mvieira4/ECE-388-Pattern-Generator-Git/README.md

# ECE-388-Pattern-Generator-Git
Demo https://youtu.be/JeO_5P8q-XI
