mvieira4/ECE-388-Pattern-Generator-Git/Report/Vieira-ECE-388-Title.tex

\begin{titlepage}
    \begin{center}
        \vspace*{4cm}

        \Huge
        \textbf{ECE-388}
        
        \Large
        \vspace{0.5cm}
        Final Project: Pattern Generator 
        
        \vspace{8.5cm}
        \textbf{Marcel Vieira}
    
        December 8, 2020
        
        \small
        \vspace{0.5cm}
        I Marcel Vieira certify that this is lab report consists only of work that is my own.
        
    \end{center}
\end{titlepage}
