mvieira4/ECE-388-Pattern-Generator-Git/Report/circuit.pdf

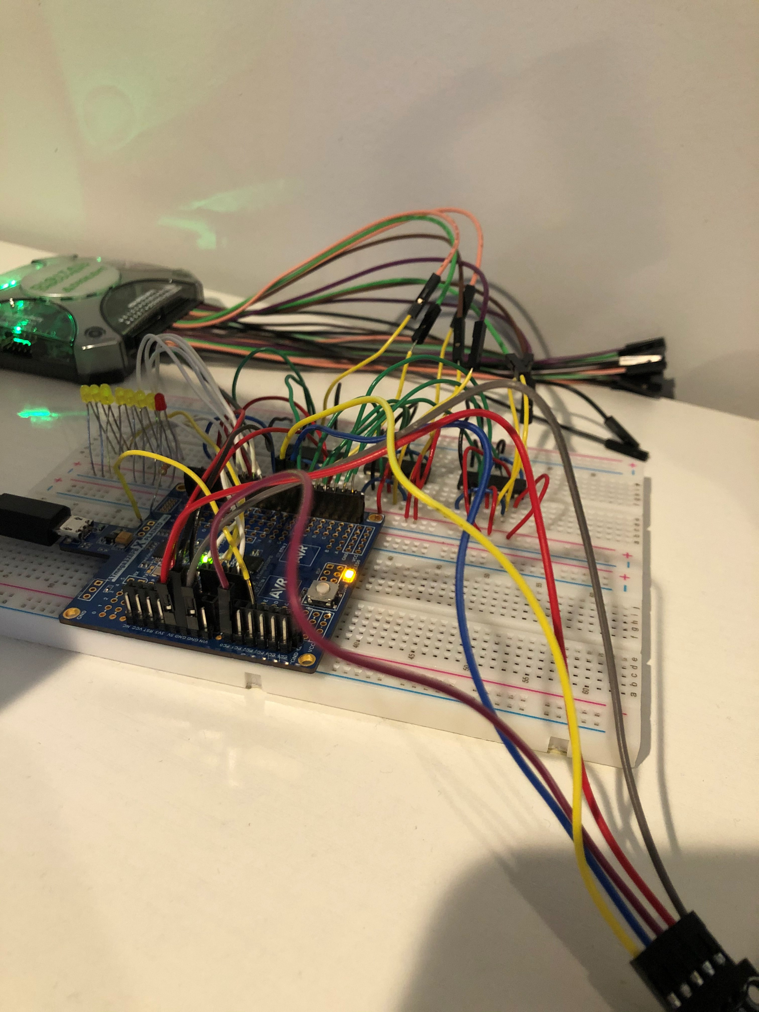
[picture p22: page 1]
