mvieira4/ECE-388-Pattern-Generator-Git/Report/ECE-388 pwr1.pdf

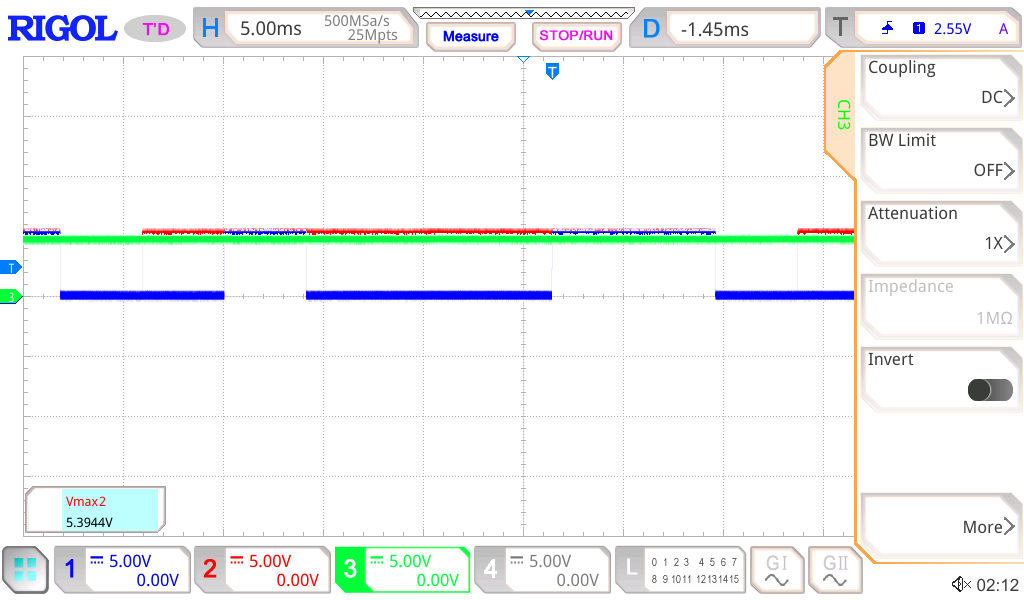
[picture p23: page 1]
