mvieira4/ECE-388-Pattern-Generator-Git/Report/ECE-388 pwr2.pdf

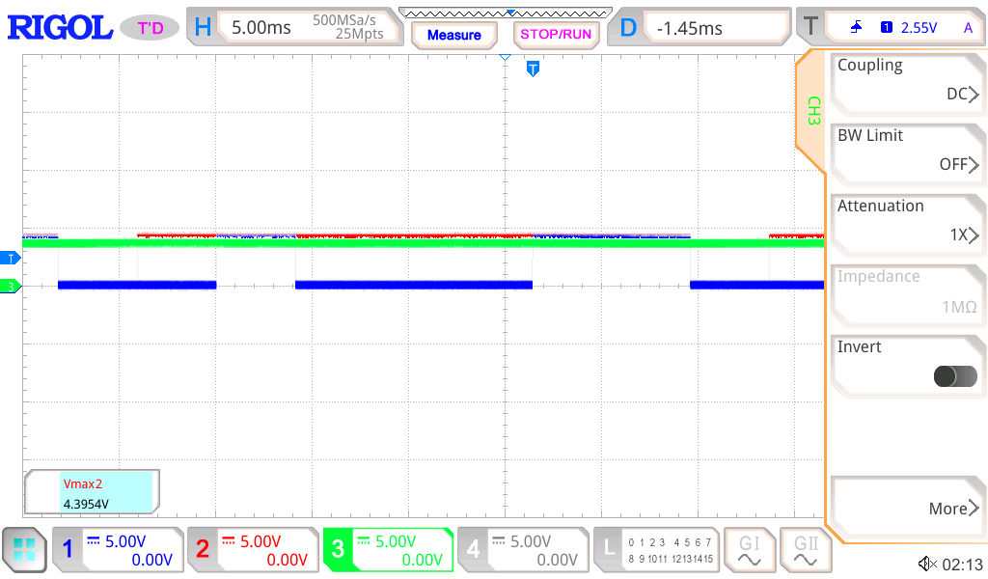
[picture p24: page 1]
