mvieira4/ECE-388-Pattern-Generator-Git/Report/ECE-388 sqrwv.pdf

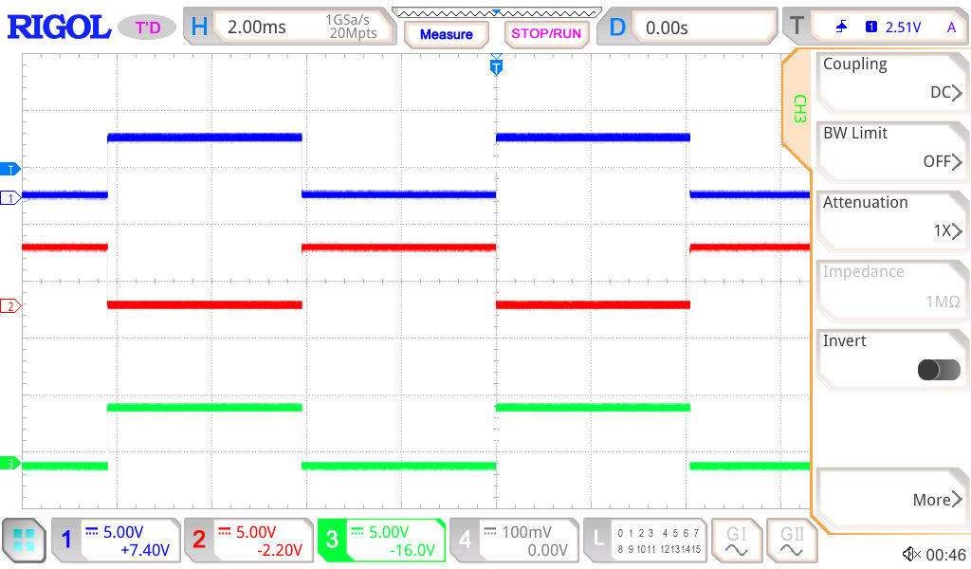
[picture p25: page 1]
