mvieira4/ECE-388-Pattern-Generator-Git/Report/ECE-388 sqrwv3.pdf

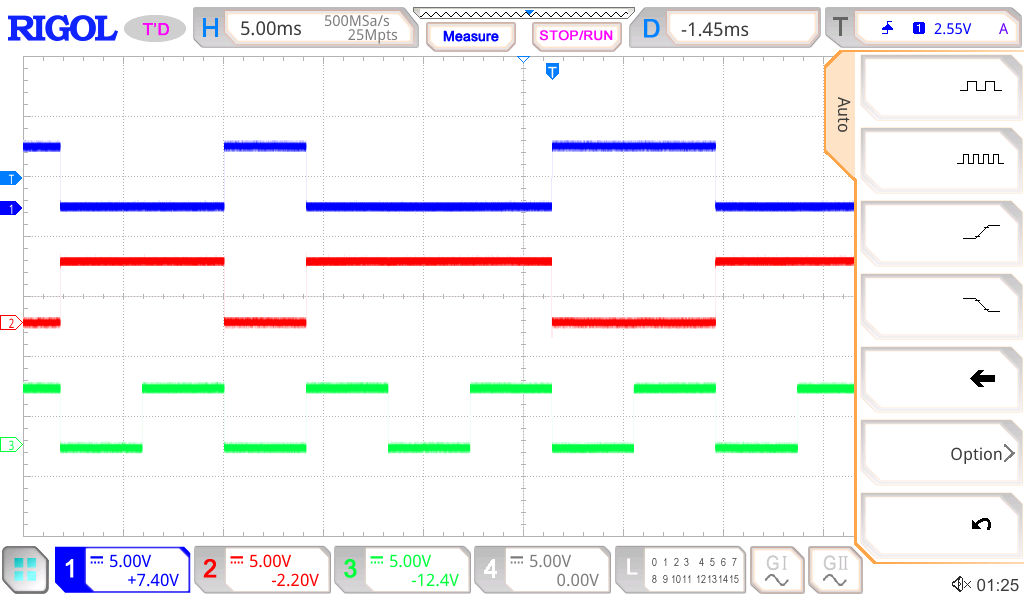
[picture p26: page 1]
