mvieira4/ECE-388-Pattern-Generator-Git/Report/circuit.jpg

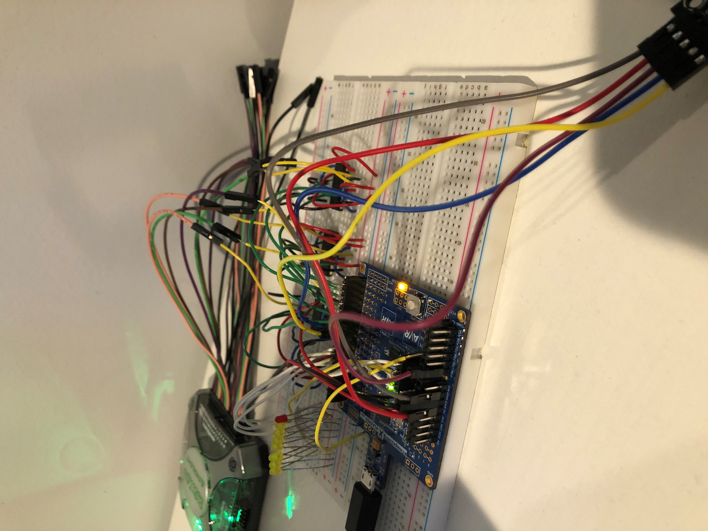
Report/circuit.jpg
