mvieira4/ECE-388-Pattern-Generator-Git/Report/ECE-388 pwr1.bmp

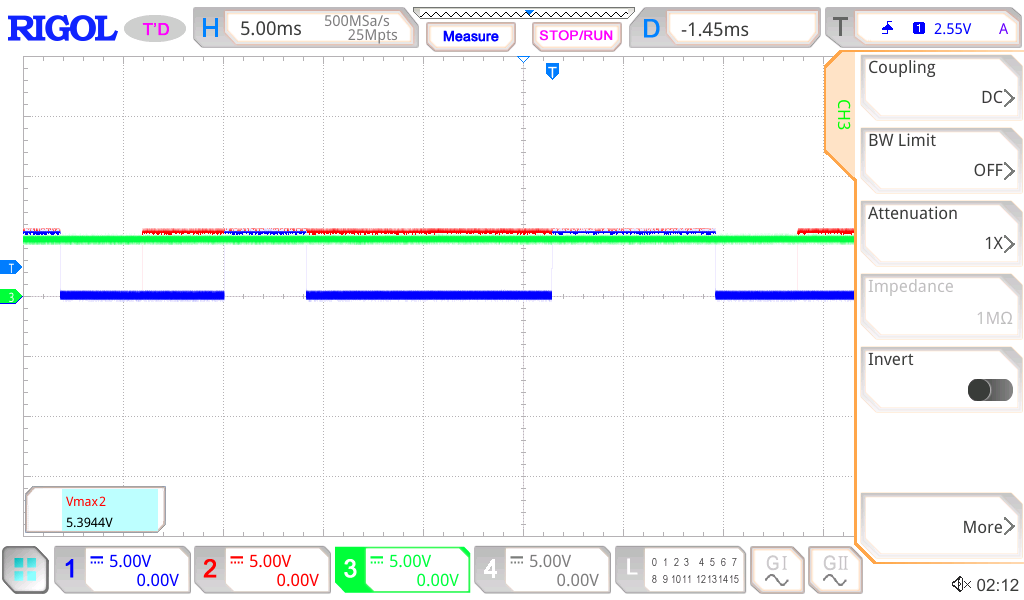
Report/ECE-388 pwr1.bmp
