mvieira4/ECE-388-Pattern-Generator-Git/Report/ECE-388 sqrwv3.bmp

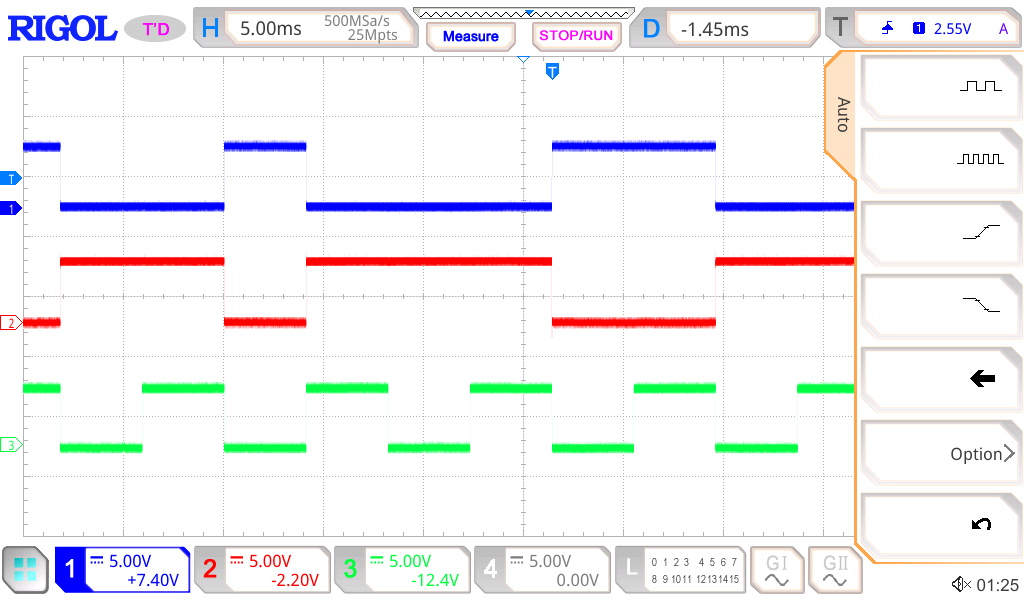
Report/ECE-388 sqrwv3.bmp
