mvieira4/ECE-388-Pattern-Generator-Git/Report/Pattern Gen Multisim V2.png

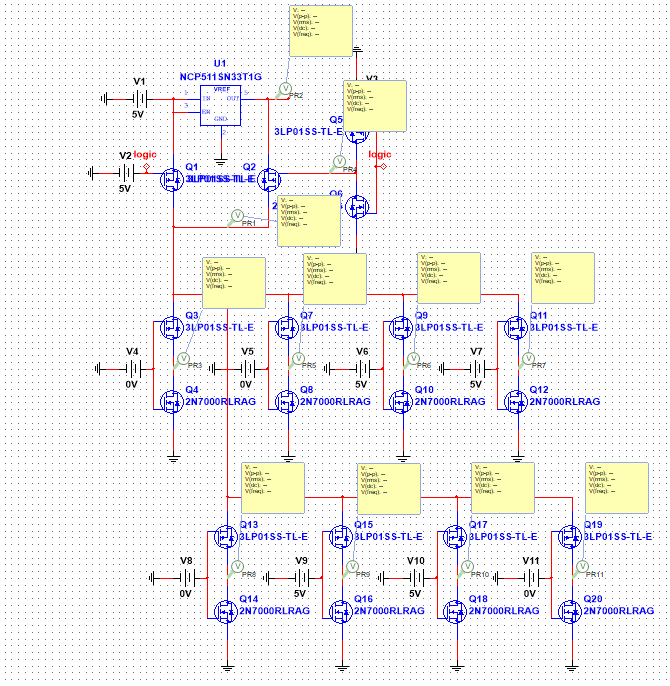
Report/Pattern Gen Multisim V2.png
