mvieira4/ECE-388-Pattern-Generator-Git/(threads)

Thread 2 (2020-11-08):

Board Submission

timChase98, 2020-11-08:
- [x] Review the submission guidelines [HERE](https://github.com/timChase98/388Example)
- [x] All project files should be version controlled
- [x] Boards will not be graded unless both Eagle files and correctly generated Gerber files are present
- [x] All traces should hit the center of pads
- [x] Power traces should have a minimum width of 12 mil or run through a plane
- [x] Silkscreen labels must include
  - [x] Your Name
  - [x] Project Name
  - [x] Date
  - [x] Version/Rev
  - [x] Github Link
- [x] Check stock sheet for correct footprints for
  - [x] Rotary encoder
  - [x] OLED display
  - [x] USB connector
- [x] Your project would fit on a much smaller board
- [x] Placement of fiducials should be
  - [x] FID1 lower left
  - [x] FID2 upper left
  - [x] FID3 lower right
- [x] Verify the orientation of the OLED display
- [x] Silk screen cannot overlay pads

These are initial comments meant to guide you through the layout process.  I will not look at your board again until your schematic passes review.  This is to reduce the workload on you by limiting the number of times you need to relayout your board due to schematic errors.

Please address these issues and push your changes. Then create a new release, increment the tag and close this issue. I will review the changes and mark this as complete or reopen the issue with additional feedback.

mvieira4, 2020-11-30:
It should be all set now

Closed 2020-11-30.
