mvieira4/ECE-388-Pattern-Generator-Git/(list of files, drawings)

Other design files:
Multisim/Channel Simulation.ms14
