mvieira4/ECE-388-Pattern-Generator-Git/PatGenV3.brd

## EAGLE design PatGenV3.brd (2020-11-11, an earlier design)

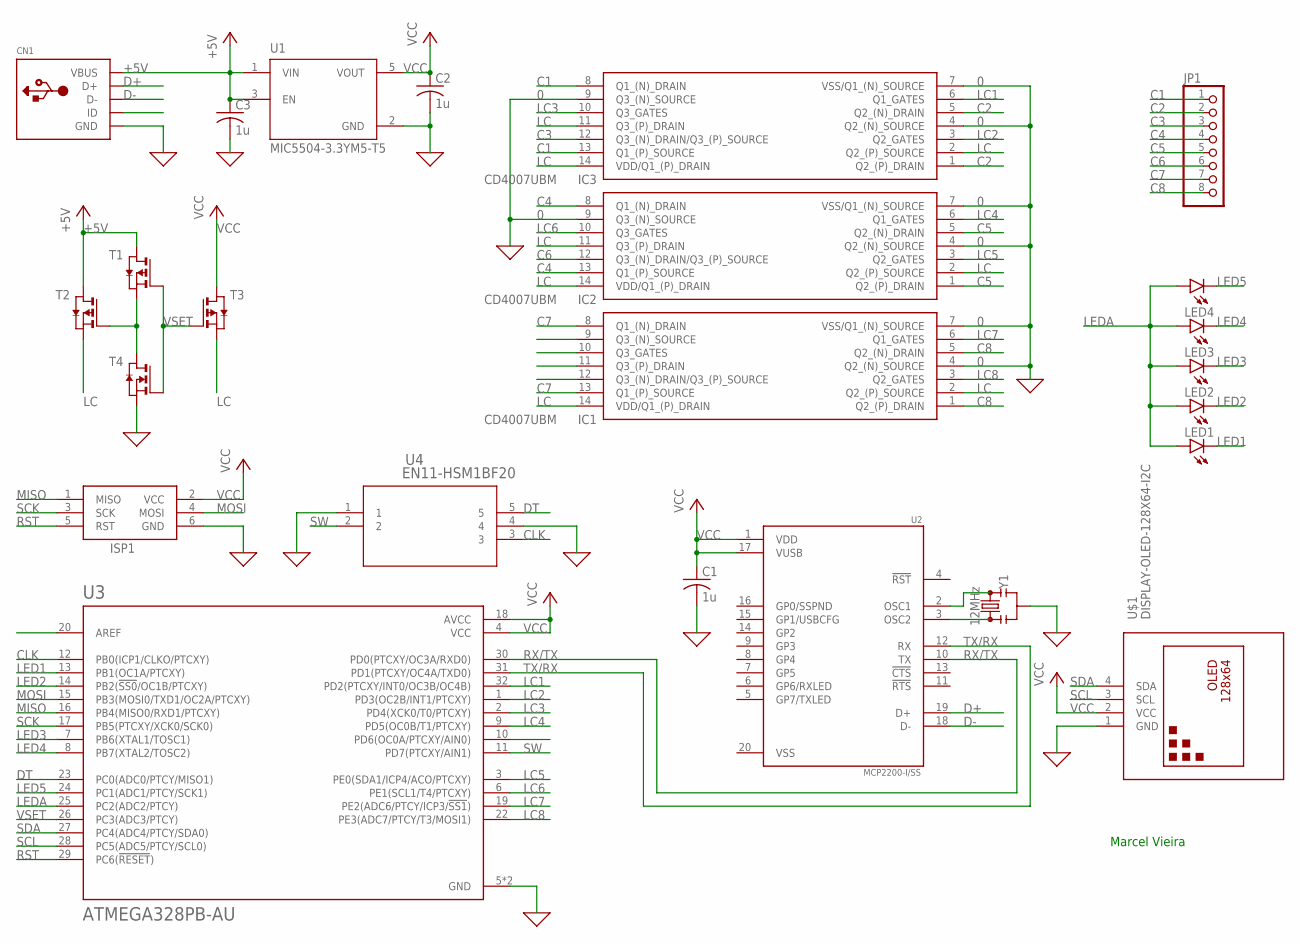
[picture p31: schematic PatGenV3.sch]

Parts:
C1, C2, C3: 1u; C0805
CN1: USBMINIB; USB-MINIB
IC1, IC2, IC3: CD4007UBM; SOIC127P600X175-14N
ISP1: AVRISP-6; AVRISP
JP1: PINHD-1X8-3.5MM; 1X08-3.5MM
LED1, LED2, LED3, LED4, LED5: LEDCHIP-LED0805; CHIP-LED0805
T1, T2, T3: PMOSSOT23; SOT-23
T4: NMOSSOT23; SOT-23
U1: MIC5504-3.3YM5-T5; SOT95P280X145-5N
U2: MCP2200-I/SS; SOP65P780X200-20N
U3: ATMEGA328PB-AU; QFP80P900X900X120-32N
U4: EN11-HSM1BF20; EN11-HSM_TTE
U$1: DISPLAY-OLED-128X64-I2C
Y1: 12MHz; RESONATOR-SMD-3.2X1.3

Connections:
0: C1.2, C2.2, C3.2, CN1.GND, IC1.4 (Q2_(N)_SOURCE), IC1.7 (VSS/Q1_(N)_SOURCE), IC2.4 (Q2_(N)_SOURCE), IC2.7 (VSS/Q1_(N)_SOURCE), IC2.9 (Q3_(N)_SOURCE), IC3.4 (Q2_(N)_SOURCE), IC3.7 (VSS/Q1_(N)_SOURCE), IC3.9 (Q3_(N)_SOURCE), ISP1.6 (GND), T4.2 (S), U1.2 (GND), U3.5 (GND), U3.21 (GND), U4.1, U4.4, U$1.1 (GND), Y1.2
+5V: C3.1, CN1.VBUS, T1.1 (D), T2.1 (D), U1.1 (VIN), U1.3 (EN)
C1: IC3.8 (Q1_(N)_DRAIN), IC3.13 (Q1_(P)_SOURCE), JP1.1
C2: IC3.1 (Q2_(P)_DRAIN), IC3.5 (Q2_(N)_DRAIN), JP1.2
C3: IC3.12 (Q3_(N)_DRAIN/Q3_(P)_SOURCE), JP1.3
C4: IC2.8 (Q1_(N)_DRAIN), IC2.13 (Q1_(P)_SOURCE), JP1.4
C5: IC2.1 (Q2_(P)_DRAIN), IC2.5 (Q2_(N)_DRAIN), JP1.5
C6: IC2.12 (Q3_(N)_DRAIN/Q3_(P)_SOURCE), JP1.6
C7: IC1.8 (Q1_(N)_DRAIN), IC1.13 (Q1_(P)_SOURCE), JP1.7
C8: IC1.1 (Q2_(P)_DRAIN), IC1.5 (Q2_(N)_DRAIN), JP1.8
CLK: U3.12 (PB0(ICP1/CLKO/PTCXY)), U4.3
D+: CN1.D+, U2.19 (D+)
D-: CN1.D-, U2.18 (D-)
DT: U3.23 (PC0(ADC0/PTCY/MISO1)), U4.5
LC: IC1.2 (Q2_(P)_SOURCE), IC1.14 (VDD/Q1_(P)_DRAIN), IC2.2 (Q2_(P)_SOURCE), IC2.11 (Q3_(P)_DRAIN), IC2.14 (VDD/Q1_(P)_DRAIN), IC3.2 (Q2_(P)_SOURCE), IC3.11 (Q3_(P)_DRAIN), IC3.14 (VDD/Q1_(P)_DRAIN), T2.2 (S), T3.2 (S)
LC1: IC3.6 (Q1_GATES), U3.32 (PD2(PTCXY/INT0/OC3B/OC4B))
LC2: IC3.3 (Q2_GATES), U3.1 (PD3(OC2B/INT1/PTCXY))
LC3: IC3.10 (Q3_GATES), U3.2 (PD4(XCK0/T0/PTCXY))
LC4: IC2.6 (Q1_GATES), U3.9 (PD5(OC0B/T1/PTCXY))
LC5: IC2.3 (Q2_GATES), U3.3 (PE0(SDA1/ICP4/ACO/PTCXY))
LC6: IC2.10 (Q3_GATES), U3.6 (PE1(SCL1/T4/PTCXY))
LC7: IC1.6 (Q1_GATES), U3.19 (PE2(ADC6/PTCY/ICP3/!SS1!))
LC8: IC1.3 (Q2_GATES), U3.22 (PE3(ADC7/PTCY/T3/MOSI1))
LED1: LED1.C, U3.13 (PB1(OC1A/PTCXY))
LED2: LED2.C, U3.14 (PB2(!SS0!/OC1B/PTCXY))
LED3: LED3.C, U3.7 (PB6(XTAL1/TOSC1))
LED4: LED4.C, U3.8 (PB7(XTAL2/TOSC2))
LED5: LED5.C, U3.24 (PC1(ADC1/PTCY/SCK1))
LEDA: LED1.A, LED2.A, LED3.A, LED4.A, LED5.A, U3.25 (PC2(ADC2/PTCY))
MISO: ISP1.1 (MISO), U3.16 (PB4(MISO0/RXD1/PTCXY))
MOSI: ISP1.4 (MOSI), U3.15 (PB3(MOSI0/TXD1/OC2A/PTCXY))
unnamed: U2.2 (OSC1), Y1.1
unnamed: T1.2 (S), T2.3 (G), T4.1 (D)
unnamed: U2.3 (OSC2), Y1.3
RST: ISP1.5 (RST), U3.29 (PC6(!RESET!))
RX/TX: U2.10 (TX), U3.30 (PD0(PTCXY/OC3A/RXD0))
SCK: ISP1.3 (SCK), U3.17 (PB5(PTCXY/XCK0/SCK0))
SCL: U3.28 (PC5(ADC5/PTCY/SCL0)), U$1.3 (SCL)
SDA: U3.27 (PC4(ADC4/PTCY/SDA0)), U$1.4 (SDA)
SW: U3.11 (PD7(PTCXY/AIN1)), U4.2
TX/RX: U2.12 (RX), U3.31 (PD1(PTCXY/OC4A/TXD0))
VCC: C1.1, C2.1, ISP1.2 (VCC), T3.1 (D), U1.5 (VOUT), U2.1 (VDD), U2.17 (VUSB), U3.4 (VCC), U3.18 (AVCC), U$1.2 (VCC)
VSET: T1.3 (G), T3.3 (G), T4.3 (G), U3.26 (PC3(ADC3/PTCY))
VSS: U2.20 (VSS)

Notes on the sheet:
Marcel Vieira

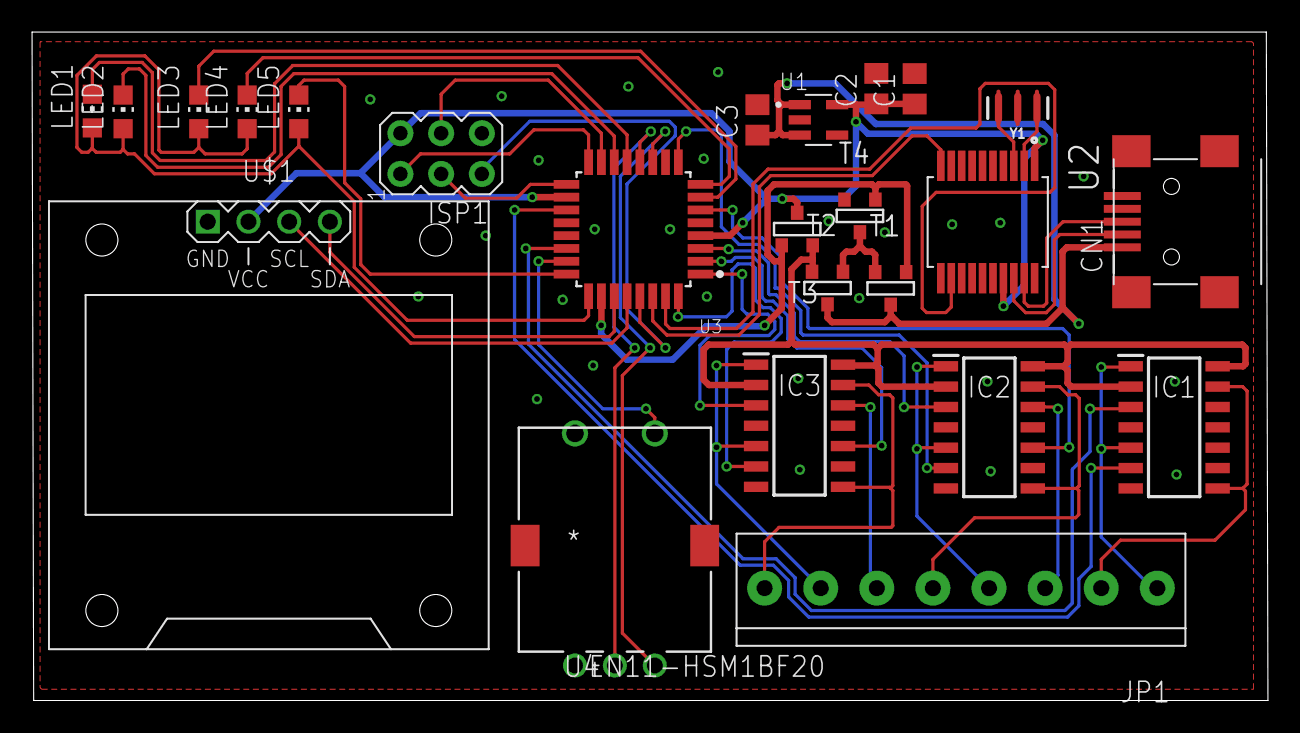
[picture p32: board PatGenV3.brd from above]

Board: 2 copper layers, 77.1 x 41.7 mm, 24 parts (0 on the bottom side), 43 nets.
