mvieira4/ECE-388-Pattern-Generator-Git/(commit log)

2020-11-09 Adding All Resources
    [Channel Simulation.ms14, ProjV1.brd, ProjV1.sch, ProjV1BOM.csv]
2020-11-09 Schematic Changes
    Added votage and ground flags and switched to running board at 3.3V
    [ProjV1.brd, ProjV1.sch]
2020-11-09 Cleared Random Files
    [Channel Simulation.ms14, ProjV1.sch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]
2020-11-09 Reordered Dir
    Got rid of Eagle dir
    [ProjV1.brd, ProjV1.sch, ProjV1BOM.csv]
2020-11-10 Updated schematic and pdf
    Switched serial chip to run on 3.3V and updated the pdf file
    [ProjV1.brd, ProjV1.sch]
2020-11-10 Update Schematic
    Changed the foot print for the rotary encoder to the EN11-HSM1BF20
2020-11-11 Updated Board Layout and Cam filse
    Rerouted wires to make board smaller
    [ProjV1.brd, ProjV1.sch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]
2020-11-11 Updated Schematic and Layout
    Removed all errors on both
    [copper_bottom.gbr, copper_top.gbr, drill_1_16.xln, gerber_job.gbrjob, profile.gbr, silkscreen_bottom.gbr, silkscreen_top.gbr, soldermask_bottom.gbr]
2020-11-11 Updated Cam Files
    Made sure cam files were up to date
    [ProjV1.brd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]
2020-11-11 Updated Layout
    Add silkscreen labels and fixed silk screen issues
2020-11-11 Updated Cam Files and PDF
    Made sure cam files and pdf were up to date
    [ProjV1.brd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]
2020-11-12 Updated Schematic
    Added power flags has issues with flag at output of the voltage regulator
    [ProjV1.brd]
2020-11-12 Update Schematic
    Labels Deleted
    [ProjV1.sch]
2020-11-13 Updated Schematic
    Fixed usb, made power source changes, got rid of missing part error relayed out board
    [ProjV1.brd, ProjV1.sch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]
2020-11-18 Updated Gerbers
    Spoke with Jin to clear up miss understanding of how to process cam files
    [PnP_ProjV1_front.csv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]
2020-11-18 Updated Gerbers
    Reuploaded incase of erros
    [ProjV1.brd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]
2020-11-19 Added copies of old versions
    Updated version numbers and add old versions for comparison and report writing
    [PnP_ProjV5_front.csv, ProjV1.sch, ProjV2.sch, ProjV3.brd, ProjV3.sch, ProjV4.brd, ProjV4.sch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]
2020-11-24 Updated Layout
    Added holes to board and moved usb over
    [ProjV5.GBL, ProjV5.GBO, ProjV5.GBS, ProjV5.GKO, ProjV5.GTL, ProjV5.GTO, ProjV5.GTS, gerber_job.gbrjob]
2020-11-30 Added Assembly Files
    Added assembly file and BOM
    [ProjV5.csv, ProjV5BOM.csv, ProjV5_assembly.csv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]
2020-11-30 Update In Case of Missed Changes
    [ProjV5.brd]
2020-11-30 Renamed Files
    Renamed some files ran more checks and fixed format up some more
    [ProjV5.brd, ProjV5.sch, ProjV5BOMSubmission.csv, ProjV5Submission.brd, ProjV5Submission.sch]
2020-11-30 Renamed Every Thing
    [PatGen.sch, PatGenV1.brd, PatGenV1.sch, PatGenV1BOM.csv, PatGenV2.sch, PatGenV3.brd, PatGenV3.sch, PatGenV4.brd]
2020-11-30 Redundant Update
    [PatGenV5Submission.GBL, PatGenV5Submission.GBO, PatGenV5Submission.GBP, PatGenV5Submission.GBS, PatGenV5Submission.GKO, PatGenV5Submission.GTL, PatGenV5Submission.GTO, PatGenV5Submission.GTP]
2020-12-08 Final Report Submission
    [Channel Simulation.ms14]
